basson/qym-solder/README.md

# qym-solder
QymSolder - Soldering station  three in one - hakko t12, hot air gun, d909/898D or analog.
