basson/qym-solder/docs/MenuStructure.md

Настройки

- Назад
- Основные
  - Время откл
  - Время выкл
  - Звук вкл/выкл
  - Охлаждение По теримстору/постоянно
  - NTC терм Нет/10k/100k
  - Сбросить настройки
- Hakko T12
  - Калибровка темп
  - Мин темп
  - Макс темп
  - Сенсор Есть/Нет
  - Время перехода в сон
  - Темп во время сна
  - PID калибровка
  - NTC терм Нет/10k/100k
- Solder Iron
  - Калибровка темп
  - Мин темп
  - Макс темп
  - Сенсор Есть/Нет
  - Время перехода в сон
  - Темп во время сна
  - PID калибровка
  - NTC терм Нет/10k/100k
- Hot Air Gun
  - Калибровка темп
  - Мин темп
  - Макс темп
  - Мин поток
  - Макс поток
  - Сенсор Есть/Нет
  - PID калибровка
  - NTC терм Нет/10k/100k
