basson/qym-solder/pcb/pcb.kicad_pcb

## KiCad design pcb/pcb.kicad_pcb (2024-02-05)

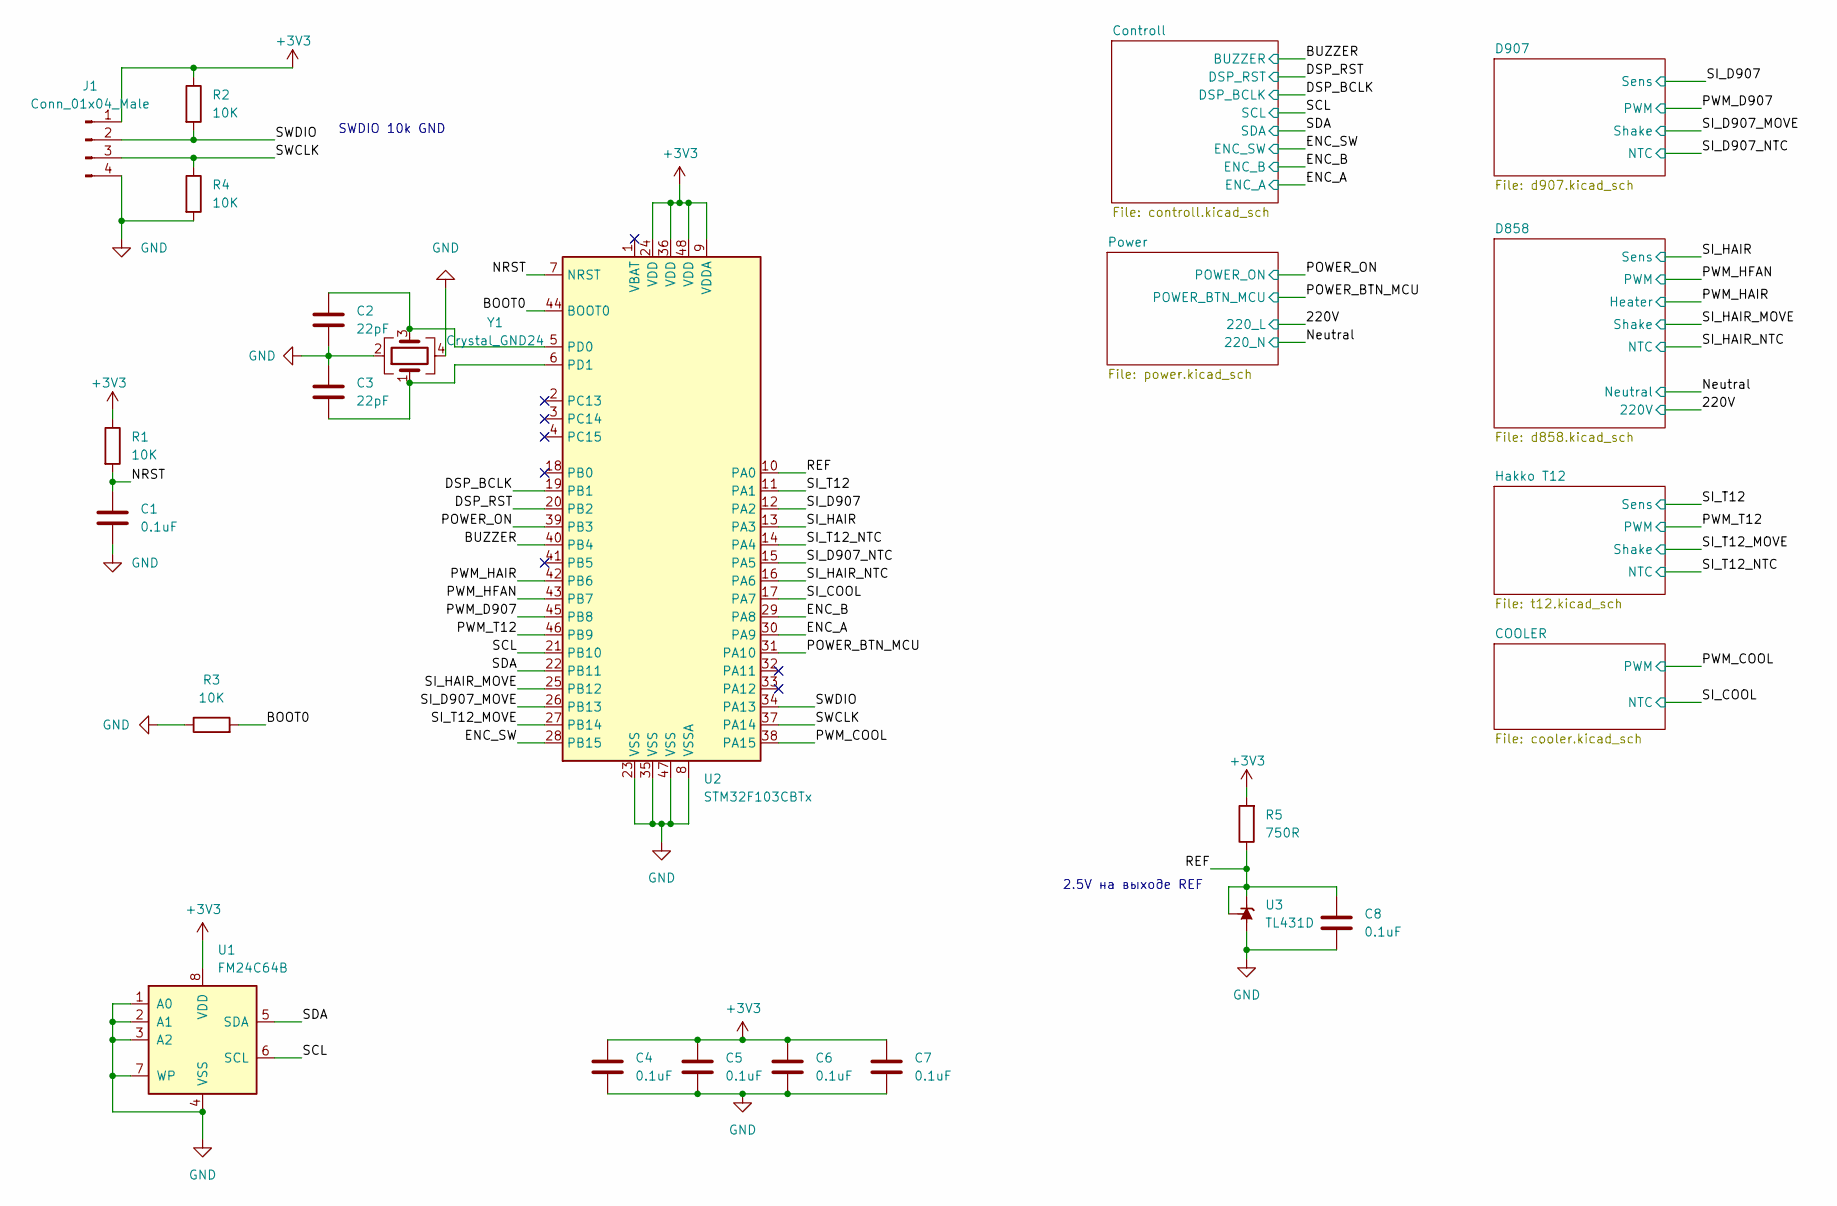
[picture p1: schematic pcb.kicad_sch]

Parts:
C1, C4, C5, C6, C7, C8: 0.1uF; C_1206_3216Metric_Pad1.33x1.80mm_HandSolder
C2, C3: 22pF; C_1206_3216Metric_Pad1.33x1.80mm_HandSolder
J1: Conn_01x04_Male; PinSocket_1x04_P2.54mm_Vertical
R1, R2, R3, R4: 10K; R_1206_3216Metric_Pad1.30x1.75mm_HandSolder
R5: 750R; R_1206_3216Metric_Pad1.30x1.75mm_HandSolder
U1: FM24C64B; SOIC-8_3.9x4.9mm_P1.27mm
U2: STM32F103CBTx; LQFP-48_7x7mm_P0.5mm
U3: TL431D; SOIC-8_3.9x4.9mm_P1.27mm
Y1: Crystal_GND24; Crystal_SMD_5032-4Pin_5.0x3.2mm

Connections:
+3V3: C4.1, C5.1, C6.1, C7.1, J1.1, R1.1, R2.1, R5.2, U1.8 (VDD), U2.9 (VDDA), U2.24 (VDD), U2.36 (VDD), U2.48 (VDD); also elsewhere on the board
/BOOT0: R3.2, U2.44 (BOOT0)
/BUZZER: U2.40 (PB4); also elsewhere on the board
/DSP_BCLK: U2.19 (PB1); also elsewhere on the board
/DSP_RST: U2.20 (PB2); also elsewhere on the board
/ENC_A: U2.30 (PA9); also elsewhere on the board
/ENC_B: U2.29 (PA8); also elsewhere on the board
/ENC_SW: U2.28 (PB15); also elsewhere on the board
/NRST: C1.2, R1.2, U2.7 (NRST)
/POWER_BTN_MCU: U2.31 (PA10); also elsewhere on the board
/POWER_ON: U2.39 (PB3); also elsewhere on the board
/PWM_COOL: U2.38 (PA15); also elsewhere on the board
/PWM_D907: U2.45 (PB8); also elsewhere on the board
/PWM_HAIR: U2.42 (PB6); also elsewhere on the board
/PWM_HFAN: U2.43 (PB7); also elsewhere on the board
/PWM_T12: U2.46 (PB9); also elsewhere on the board
/REF: C8.1, R5.1, U2.10 (PA0), U3.1 (K), U3.8 (REF)
/SCL: U1.6 (SCL), U2.21 (PB10); also elsewhere on the board
/SDA: U1.5 (SDA), U2.22 (PB11); also elsewhere on the board
/SI_COOL: U2.17 (PA7); also elsewhere on the board
/SI_D907: U2.12 (PA2); also elsewhere on the board
/SI_D907_MOVE: U2.26 (PB13); also elsewhere on the board
/SI_D907_NTC: U2.15 (PA5); also elsewhere on the board
/SI_HAIR: U2.13 (PA3); also elsewhere on the board
/SI_HAIR_MOVE: U2.25 (PB12); also elsewhere on the board
/SI_HAIR_NTC: U2.16 (PA6); also elsewhere on the board
/SI_T12: U2.11 (PA1); also elsewhere on the board
/SI_T12_MOVE: U2.27 (PB14); also elsewhere on the board
/SI_T12_NTC: U2.14 (PA4); also elsewhere on the board
/SWCLK: J1.3, R4.1, U2.37 (PA14)
/SWDIO: J1.2, R2.2, U2.34 (PA13)
GND: C1.1, C2.1, C3.2, C4.2, C5.2, C6.2, C7.2, C8.2, J1.4, R3.1, R4.2, U1.1 (A0), U1.2 (A1), U1.3 (A2), U1.4 (VSS), U1.7 (WP), U2.8 (VSSA), U2.23 (VSS), U2.35 (VSS), U2.47 (VSS), U3.2 (A), U3.3 (A), U3.6 (A), U3.7 (A), Y1.2, Y1.4; also elsewhere on the board
unnamed: C2.2, U2.5 (PD0), Y1.3
unnamed: C3.1, U2.6 (PD1), Y1.1

Notes on the sheet:
2.5V на выходе REF
SWDIO 10k GND

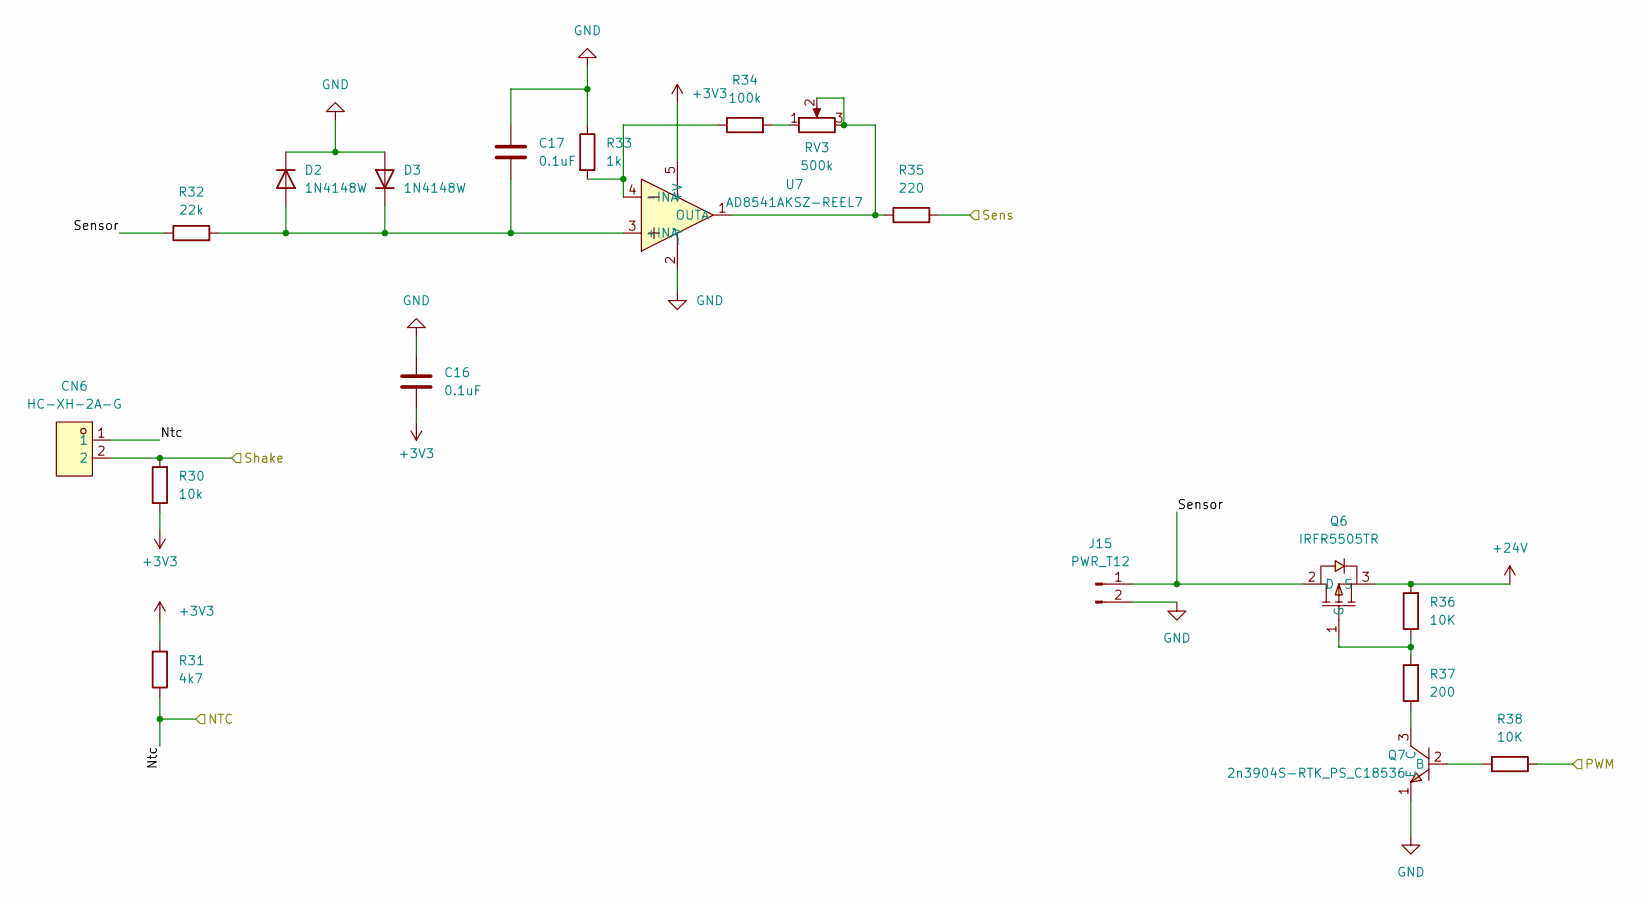
[picture p2: schematic t12.kicad_sch]

Parts:
C16, C17: 0.1uF; C_1206_3216Metric_Pad1.33x1.80mm_HandSolder
CN6: HC-XH-2A-G; CONN-TH_2P-P2.50_HC-XH-2A-G; LCSC Part C5341201
D2, D3: 1N4148W; D_SOD-123
J15: PWR_T12; TerminalBlock_Phoenix_MKDS-1,5-2_1x02_P5.00mm_Horizontal
Q6: IRFR5505TR; TO-252-3_L6.5-W5.8-P4.58-BR; LCSC Part C725084
Q7: 2n3904S-RTK_PS_C18536; SOT-23-3_L2.9-W1.3-P1.90-LS2.4-TR; LCSC Part C18536
R30: 10k; R_1206_3216Metric_Pad1.30x1.75mm_HandSolder
R31: 4k7; R_1206_3216Metric_Pad1.30x1.75mm_HandSolder
R32: 22k; R_1206_3216Metric_Pad1.30x1.75mm_HandSolder
R33: 1k; R_1206_3216Metric_Pad1.30x1.75mm_HandSolder
R34: 100k; R_1206_3216Metric_Pad1.30x1.75mm_HandSolder
R35: 220; R_1206_3216Metric_Pad1.30x1.75mm_HandSolder
R36, R38: 10K; R_1206_3216Metric_Pad1.30x1.75mm_HandSolder
R37: 200; R_1206_3216Metric_Pad1.30x1.75mm_HandSolder
RV3: 500k; Potentiometer_Bourns_3296W_Vertical
U7: AD8541AKSZ-REEL7; SOT-23-5; LCSC Part C143907

Connections:
+3V3: C16.2, R30.1, R31.2, U7.5 (+V); also elsewhere on the board
+24V: Q6.3 (S), R36.2; also elsewhere on the board
/Hakko T12/Sensor: J15.1, Q6.2 (D), R32.1
/PWM_T12: R38.1; also elsewhere on the board
/SI_T12: R35.2; also elsewhere on the board
/SI_T12_MOVE: CN6.2, R30.2; also elsewhere on the board
/SI_T12_NTC: CN6.1, R31.1; also elsewhere on the board
GND: C16.1, C17.1, D2.1 (K), D3.2 (A), J15.2, Q7.1 (E), R33.1, U7.2 (-V); also elsewhere on the board
unnamed: C17.2, D2.2 (A), D3.1 (K), R32.2, U7.3 (+INA)
unnamed: Q6.1 (G), R36.1, R37.2
unnamed: Q7.2 (B), R38.2
unnamed: Q7.3 (C), R37.1
unnamed: R34.2, RV3.1
unnamed: R33.2, R34.1, U7.4 (-INA)
unnamed: R35.1, RV3.2, RV3.3, U7.1 (OUTA)

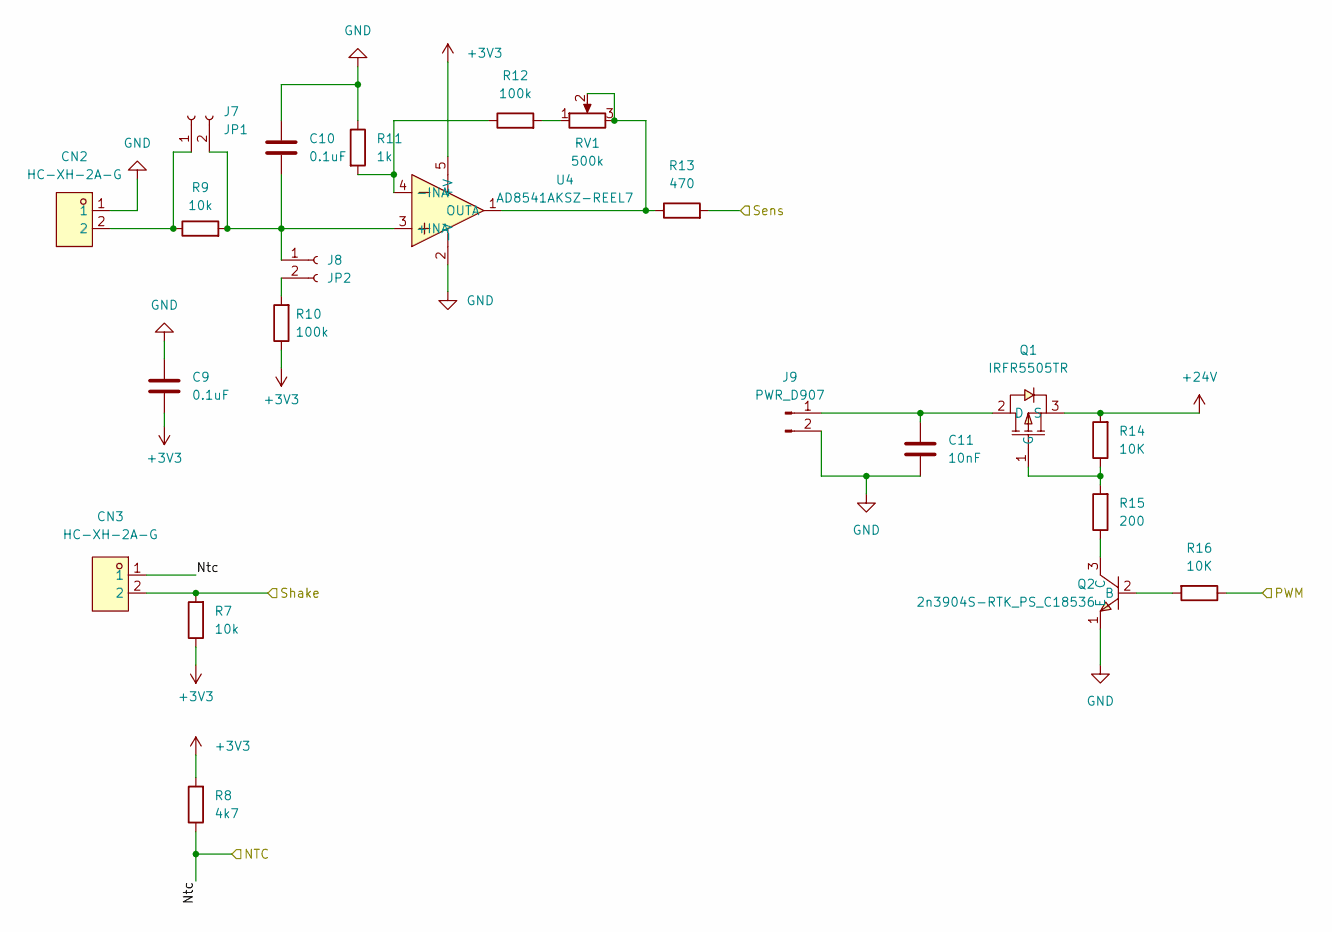
[picture p3: schematic d907.kicad_sch]

Parts:
C9, C10: 0.1uF; C_1206_3216Metric_Pad1.33x1.80mm_HandSolder
C11: 10nF; C_1206_3216Metric_Pad1.33x1.80mm_HandSolder
CN2, CN3: HC-XH-2A-G; CONN-TH_2P-P2.50_HC-XH-2A-G; LCSC Part C5341201
J7: JP1; PinSocket_1x02_P2.54mm_Vertical
J8: JP2; PinSocket_1x02_P2.54mm_Vertical
J9: PWR_D907; TerminalBlock_Phoenix_MKDS-1,5-2_1x02_P5.00mm_Horizontal
Q1: IRFR5505TR; TO-252-3_L6.5-W5.8-P4.58-BR; LCSC Part C725084
Q2: 2n3904S-RTK_PS_C18536; SOT-23-3_L2.9-W1.3-P1.90-LS2.4-TR; LCSC Part C18536
R7, R9: 10k; R_1206_3216Metric_Pad1.30x1.75mm_HandSolder
R8: 4k7; R_1206_3216Metric_Pad1.30x1.75mm_HandSolder
R10, R12: 100k; R_1206_3216Metric_Pad1.30x1.75mm_HandSolder
R11: 1k; R_1206_3216Metric_Pad1.30x1.75mm_HandSolder
R13: 470; R_1206_3216Metric_Pad1.30x1.75mm_HandSolder
R14, R16: 10K; R_1206_3216Metric_Pad1.30x1.75mm_HandSolder
R15: 200; R_1206_3216Metric_Pad1.30x1.75mm_HandSolder
RV1: 500k; Potentiometer_Bourns_3296W_Vertical
U4: AD8541AKSZ-REEL7; SOT-23-5; LCSC Part C143907

Connections:
+3V3: C9.2, R7.1, R8.2, R10.1, U4.5 (+V); also elsewhere on the board
+24V: Q1.3 (S), R14.2; also elsewhere on the board
/PWM_D907: R16.1; also elsewhere on the board
/SI_D907: R13.2; also elsewhere on the board
/SI_D907_MOVE: CN3.2, R7.2; also elsewhere on the board
/SI_D907_NTC: CN3.1, R8.1; also elsewhere on the board
GND: C9.1, C10.1, C11.1, CN2.1, J9.2, Q2.1 (E), R11.1, U4.2 (-V); also elsewhere on the board
unnamed: CN2.2, J7.1, R9.1
unnamed: C10.2, J7.2, J8.1, R9.2, U4.3 (+INA)
unnamed: J8.2, R10.2
unnamed: C11.2, J9.1, Q1.2 (D)
unnamed: Q1.1 (G), R14.1, R15.2
unnamed: Q2.2 (B), R16.2
unnamed: Q2.3 (C), R15.1
unnamed: R12.2, RV1.1
unnamed: R11.2, R12.1, U4.4 (-INA)
unnamed: R13.1, RV1.2, RV1.3, U4.1 (OUTA)

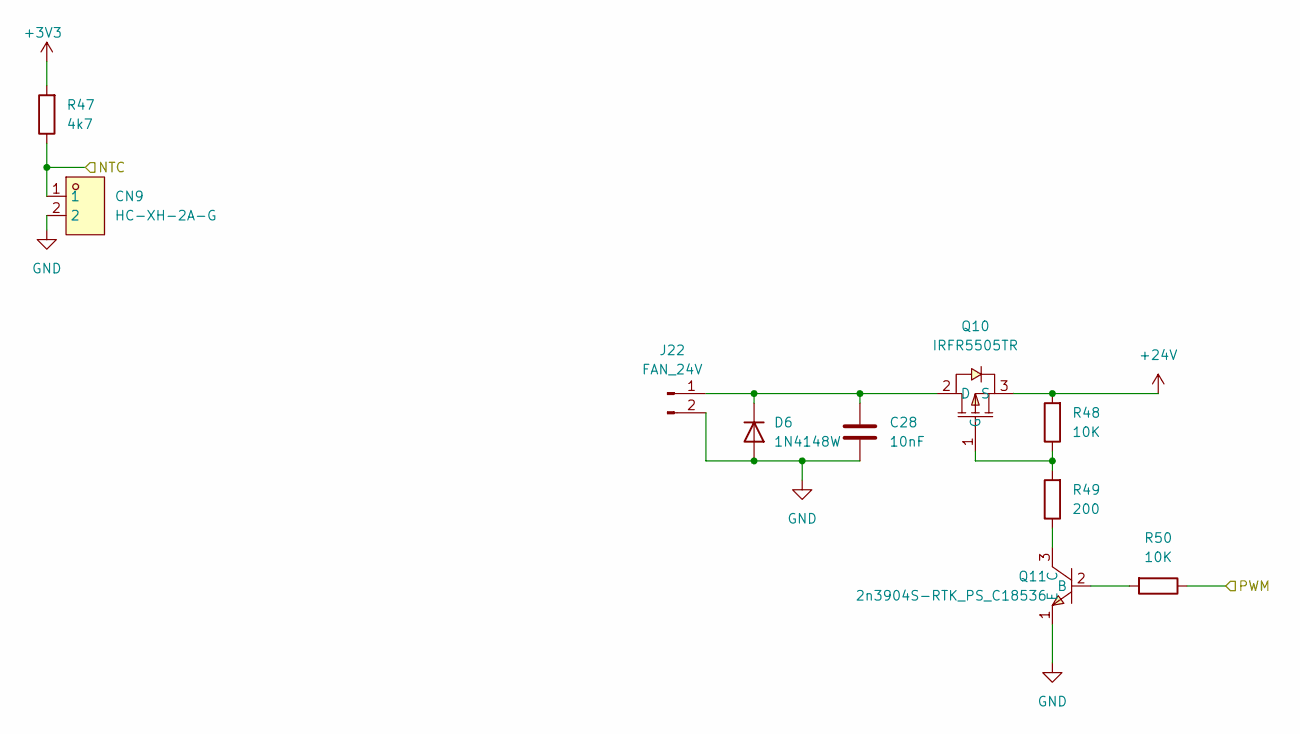
[picture p4: schematic cooler.kicad_sch]

Parts:
C28: 10nF; C_1206_3216Metric_Pad1.33x1.80mm_HandSolder
CN9: HC-XH-2A-G; CONN-TH_2P-P2.50_HC-XH-2A-G; LCSC Part C5341201
D6: 1N4148W; D_SOD-123
J22: FAN_24V; TerminalBlock_Phoenix_MKDS-1,5-2_1x02_P5.00mm_Horizontal
Q10: IRFR5505TR; TO-252-3_L6.5-W5.8-P4.58-BR; LCSC Part C725084
Q11: 2n3904S-RTK_PS_C18536; SOT-23-3_L2.9-W1.3-P1.90-LS2.4-TR; LCSC Part C18536
R47: 4k7; R_1206_3216Metric_Pad1.30x1.75mm_HandSolder
R48, R50: 10K; R_1206_3216Metric_Pad1.30x1.75mm_HandSolder
R49: 200; R_1206_3216Metric_Pad1.30x1.75mm_HandSolder

Connections:
+3V3: R47.2; also elsewhere on the board
+24V: Q10.3 (S), R48.2; also elsewhere on the board
/PWM_COOL: R50.1; also elsewhere on the board
/SI_COOL: CN9.1, R47.1; also elsewhere on the board
GND: C28.1, CN9.2, D6.2 (A), J22.2, Q11.1 (E); also elsewhere on the board
unnamed: C28.2, D6.1 (K), J22.1, Q10.2 (D)
unnamed: Q10.1 (G), R48.1, R49.2
unnamed: Q11.2 (B), R50.2
unnamed: Q11.3 (C), R49.1

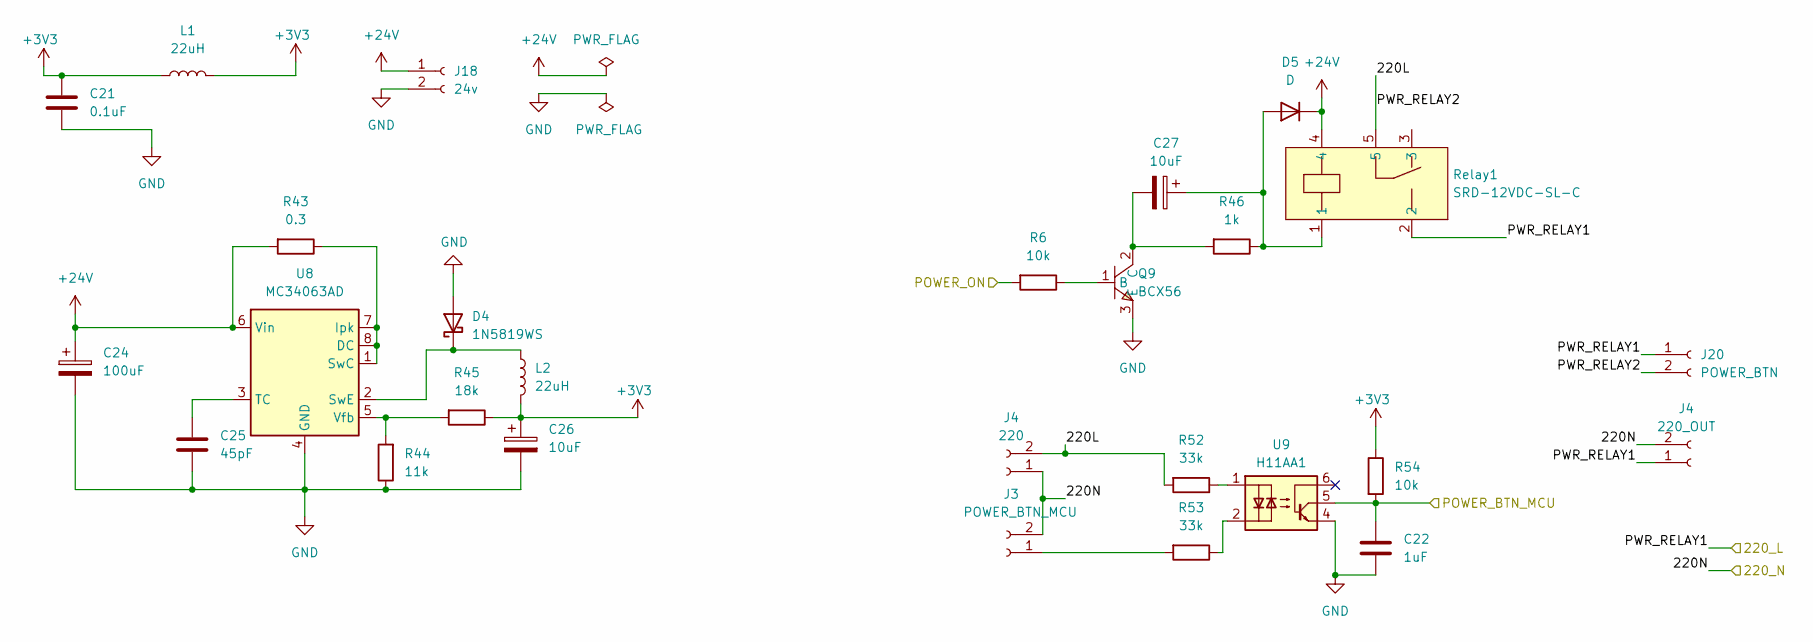
[picture p5: schematic power.kicad_sch]

Parts:
C21: 0.1uF; C_1206_3216Metric_Pad1.33x1.80mm_HandSolder
C22: 1uF; C_1206_3216Metric_Pad1.33x1.80mm_HandSolder
C24: 100uF; CP_Radial_D8.0mm_P3.80mm
C25: 45pF; C_1206_3216Metric_Pad1.33x1.80mm_HandSolder
C26, C27: 10uF; CP_Radial_D5.0mm_P2.50mm
D4: 1N5819WS; D_2114_3652Metric_Pad1.85x3.75mm_HandSolder
D5: D; D_SMA_Handsoldering
J3: POWER_BTN_MCU; TerminalBlock_Phoenix_MKDS-1,5-2_1x02_P5.00mm_Horizontal
J4: 220; TerminalBlock_Phoenix_MKDS-1,5-2_1x02_P5.00mm_Horizontal
J18: 24v; TerminalBlock_Phoenix_MKDS-1,5-2_1x02_P5.00mm_Horizontal
J20: POWER_BTN; TerminalBlock_Phoenix_MKDS-1,5-2_1x02_P5.00mm_Horizontal
L1: 22uH; L_1206_3216Metric_Pad1.22x1.90mm_HandSolder
L2: 22uH; L_6.3x6.3_H3
Q9: BCX56; SOT-89-3_L4.5-W2.5-P1.50-LS4.2-BR; LCSC Part C24280
R6, R54: 10k; R_1206_3216Metric_Pad1.30x1.75mm_HandSolder
R43: 0.3; R_1206_3216Metric_Pad1.30x1.75mm_HandSolder
R44: 11k; R_1206_3216Metric_Pad1.30x1.75mm_HandSolder
R45: 18k; R_1206_3216Metric_Pad1.30x1.75mm_HandSolder
R46: 1k; R_1206_3216Metric_Pad1.30x1.75mm_HandSolder
R52, R53: 33k; R_2512_6332Metric_Pad1.40x3.35mm_HandSolder
Relay1: SRD-12VDC-SL-C; RELAY-TH_SRD-XXVDC-XL-C; LCSC Part C30431
U8: MC34063AD; SOIC-8_3.9x4.9mm_P1.27mm
U9: H11AA1; DIP-6_W7.62mm_SMDSocket_SmallPads

Connections:
+3V3: C21.1, C26.1, L1.1, L1.2, L2.2, R45.1, R54.1; also elsewhere on the board
+24V: C24.1, D5.1 (K), J18.1, R43.2, Relay1.4, U8.6 (Vin); also elsewhere on the board
/POWER_BTN_MCU: C22.1, R54.2, U9.5; also elsewhere on the board
/POWER_ON: R6.2; also elsewhere on the board
GND: C21.2, C22.2, C24.2, C25.2, C26.2, D4.2 (A), J18.2, Q9.3 (E), R44.1, U8.4 (GND), U9.4; also elsewhere on the board
unnamed: D4.1 (K), L2.1, U8.2 (SwE)
unnamed: C27.1, D5.2 (A), R46.1, Relay1.1
unnamed: J3.1, R53.2
unnamed: Q9.1 (B), R6.1
unnamed: C27.2, Q9.2 (C), R46.2
unnamed: R52.1, U9.1
unnamed: R53.1, U9.2
unnamed: R43.1, U8.1 (SwC), U8.7 (Ipk), U8.8 (DC)
unnamed: C25.1, U8.3 (TC)
unnamed: R44.2, R45.2, U8.5 (Vfb)

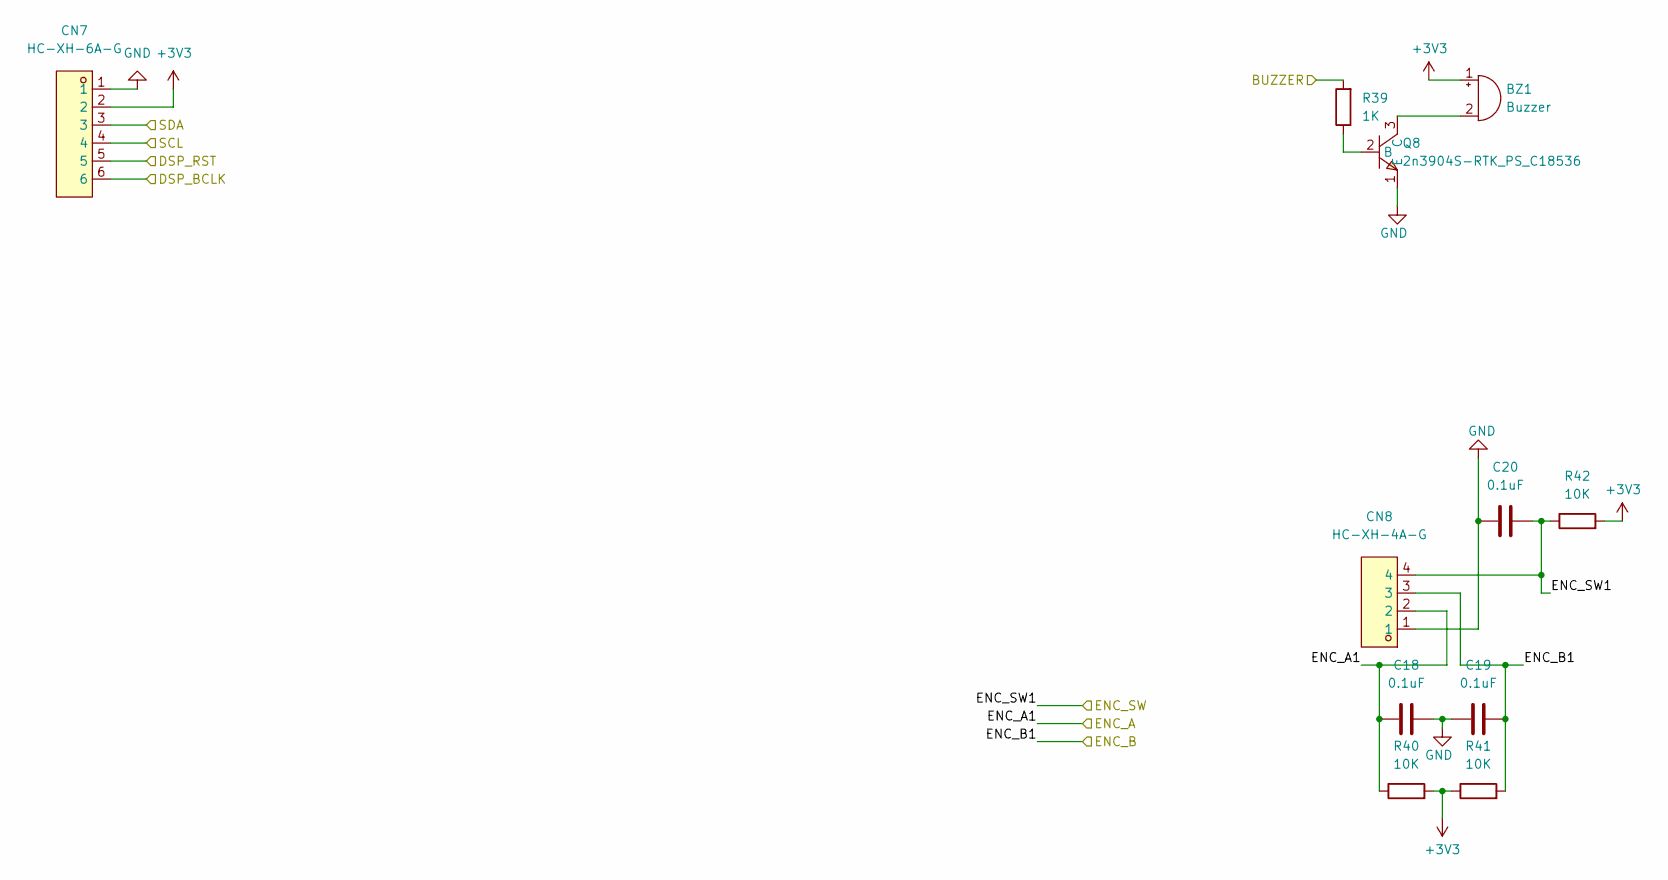
[picture p6: schematic controll.kicad_sch]

Parts:
BZ1: Buzzer; Buzzer_12x9.5RM7.6
C18, C19, C20: 0.1uF; C_1206_3216Metric_Pad1.33x1.80mm_HandSolder
CN7: HC-XH-6A-G; CONN-TH_6P-P2.50_HC-XH-6A-G; LCSC Part C5341205
CN8: HC-XH-4A-G; CONN-TH_4P-P2.50_HC-XH-4A-G; LCSC Part C5341203
Q8: 2n3904S-RTK_PS_C18536; SOT-23-3_L2.9-W1.3-P1.90-LS2.4-TR; LCSC Part C18536
R39: 1K; R_1206_3216Metric_Pad1.30x1.75mm_HandSolder
R40, R41, R42: 10K; R_1206_3216Metric_Pad1.30x1.75mm_HandSolder

Connections:
+3V3: BZ1.1 (-), CN7.2, R40.2, R41.1, R42.2; also elsewhere on the board
/BUZZER: R39.2; also elsewhere on the board
/DSP_BCLK: CN7.6; also elsewhere on the board
/DSP_RST: CN7.5; also elsewhere on the board
/ENC_A: C18.1, CN8.2, R40.1; also elsewhere on the board
/ENC_B: C19.2, CN8.3, R41.2; also elsewhere on the board
/ENC_SW: C20.1, CN8.4, R42.1; also elsewhere on the board
/SCL: CN7.4; also elsewhere on the board
/SDA: CN7.3; also elsewhere on the board
GND: C18.2, C19.1, C20.2, CN7.1, CN8.1, Q8.1 (E); also elsewhere on the board
unnamed: BZ1.2 (+), Q8.3 (C)
unnamed: Q8.2 (B), R39.1

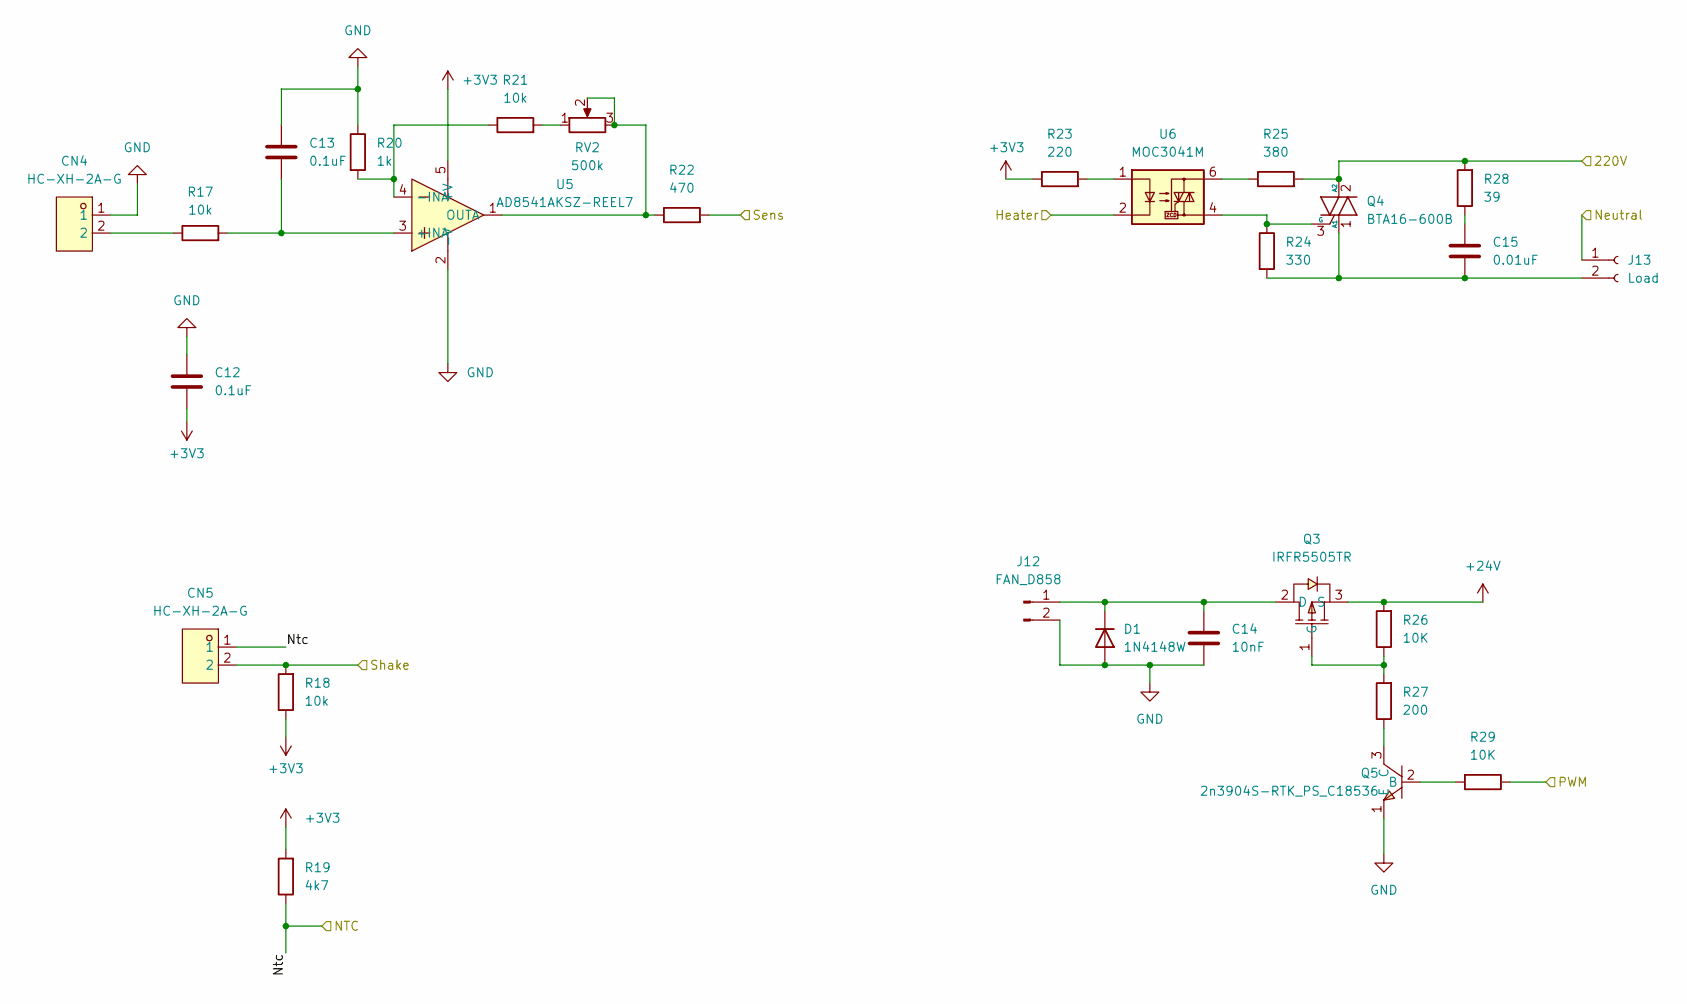
[picture p7: schematic d858.kicad_sch]

Parts:
C12, C13: 0.1uF; C_1206_3216Metric_Pad1.33x1.80mm_HandSolder
C14: 10nF; C_1206_3216Metric_Pad1.33x1.80mm_HandSolder
C15: 0.01uF; C_Disc_D11.0mm_W5.0mm_P5.00mm
CN4, CN5: HC-XH-2A-G; CONN-TH_2P-P2.50_HC-XH-2A-G; LCSC Part C5341201
D1: 1N4148W; D_SOD-123
J12: FAN_D858; TerminalBlock_Phoenix_MKDS-1,5-2_1x02_P5.00mm_Horizontal
J13: Load; TerminalBlock_Phoenix_MKDS-1,5-2_1x02_P5.00mm_Horizontal
Q3: IRFR5505TR; TO-252-3_L6.5-W5.8-P4.58-BR; LCSC Part C725084
Q4: BTA16-600B; TO-220-3_Vertical
Q5: 2n3904S-RTK_PS_C18536; SOT-23-3_L2.9-W1.3-P1.90-LS2.4-TR; LCSC Part C18536
R17, R18, R21: 10k; R_1206_3216Metric_Pad1.30x1.75mm_HandSolder
R19: 4k7; R_1206_3216Metric_Pad1.30x1.75mm_HandSolder
R20: 1k; R_1206_3216Metric_Pad1.30x1.75mm_HandSolder
R22: 470; R_1206_3216Metric_Pad1.30x1.75mm_HandSolder
R23: 220; R_1206_3216Metric_Pad1.30x1.75mm_HandSolder
R24: 330; R_2512_6332Metric_Pad1.40x3.35mm_HandSolder
R25: 380; R_2512_6332Metric_Pad1.40x3.35mm_HandSolder
R26, R29: 10K; R_1206_3216Metric_Pad1.30x1.75mm_HandSolder
R27: 200; R_1206_3216Metric_Pad1.30x1.75mm_HandSolder
R28: 39; R_2512_6332Metric_Pad1.40x3.35mm_HandSolder
RV2: 500k; Potentiometer_Bourns_3296W_Vertical
U5: AD8541AKSZ-REEL7; SOT-23-5; LCSC Part C143907
U6: MOC3041M; DIP-6_W7.62mm_LongPads

Connections:
+3V3: C12.2, R18.1, R19.2, R23.1, U5.5 (+V); also elsewhere on the board
+24V: Q3.3 (S), R26.2; also elsewhere on the board
/PWM_HAIR: U6.2; also elsewhere on the board
/PWM_HFAN: R29.1; also elsewhere on the board
/SI_HAIR: R22.2; also elsewhere on the board
/SI_HAIR_MOVE: CN5.2, R18.2; also elsewhere on the board
/SI_HAIR_NTC: CN5.1, R19.1; also elsewhere on the board
GND: C12.1, C13.1, C14.1, CN4.1, D1.2 (A), J12.2, Q5.1 (E), R20.1, U5.2 (-V); also elsewhere on the board
unnamed: C15.1, R28.1
unnamed: CN4.2, R17.1
unnamed: C14.2, D1.1 (K), J12.1, Q3.2 (D)
unnamed: C15.2, J13.2, Q4.1 (A1), R24.2
unnamed: Q3.1 (G), R26.1, R27.2
unnamed: Q4.3 (G), R24.1, U6.4
unnamed: Q5.2 (B), R29.2
unnamed: Q5.3 (C), R27.1
unnamed: R21.2, RV2.1
unnamed: R23.2, U6.1
unnamed: R25.1, U6.6
unnamed: C13.2, R17.2, U5.3 (+INA)
unnamed: R20.2, R21.1, U5.4 (-INA)
unnamed: R22.1, RV2.2, RV2.3, U5.1 (OUTA)

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
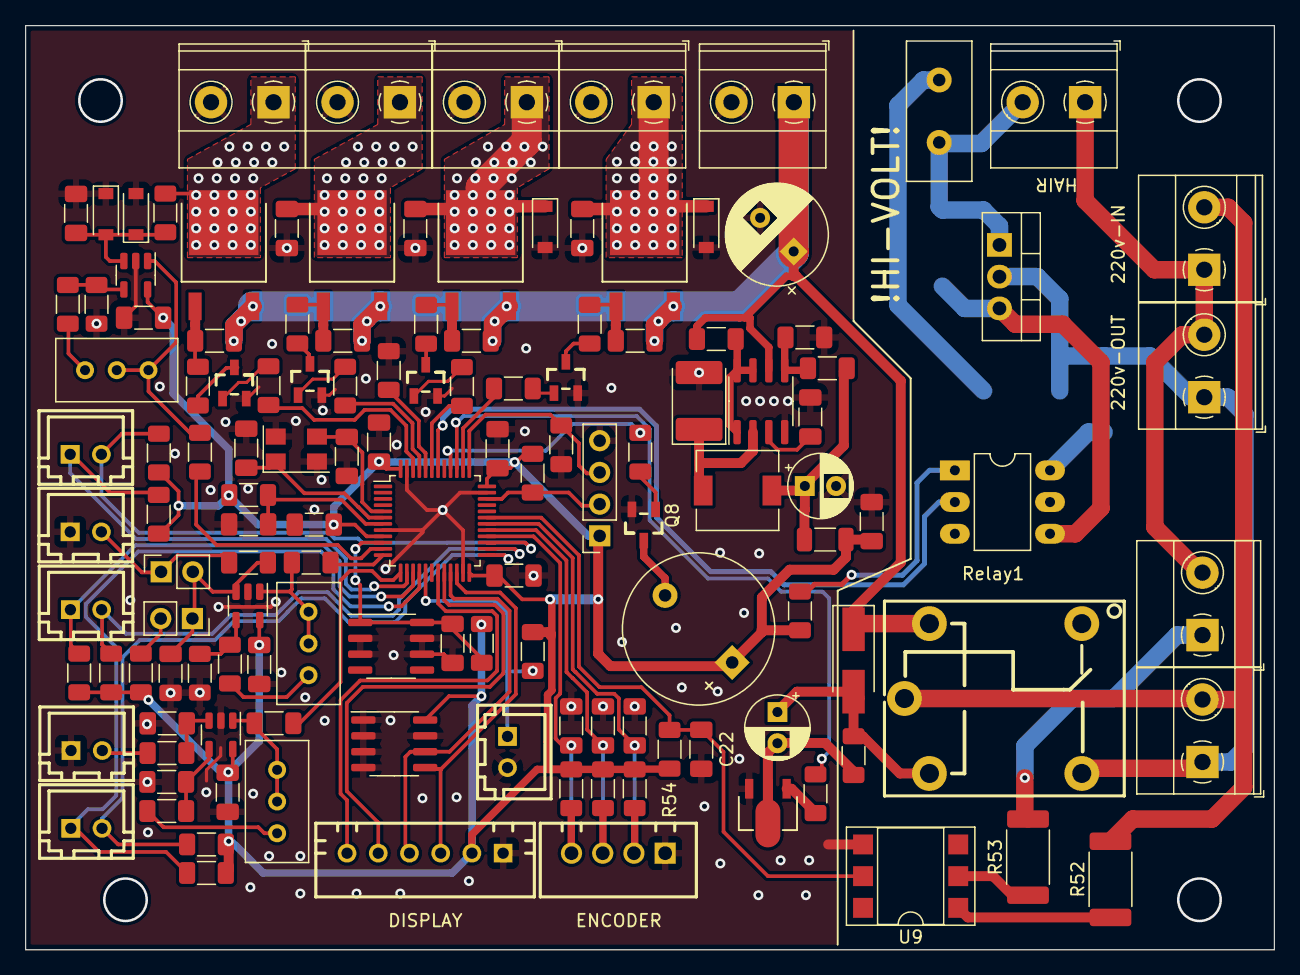
[picture p8: board pcb.kicad_pcb from above]

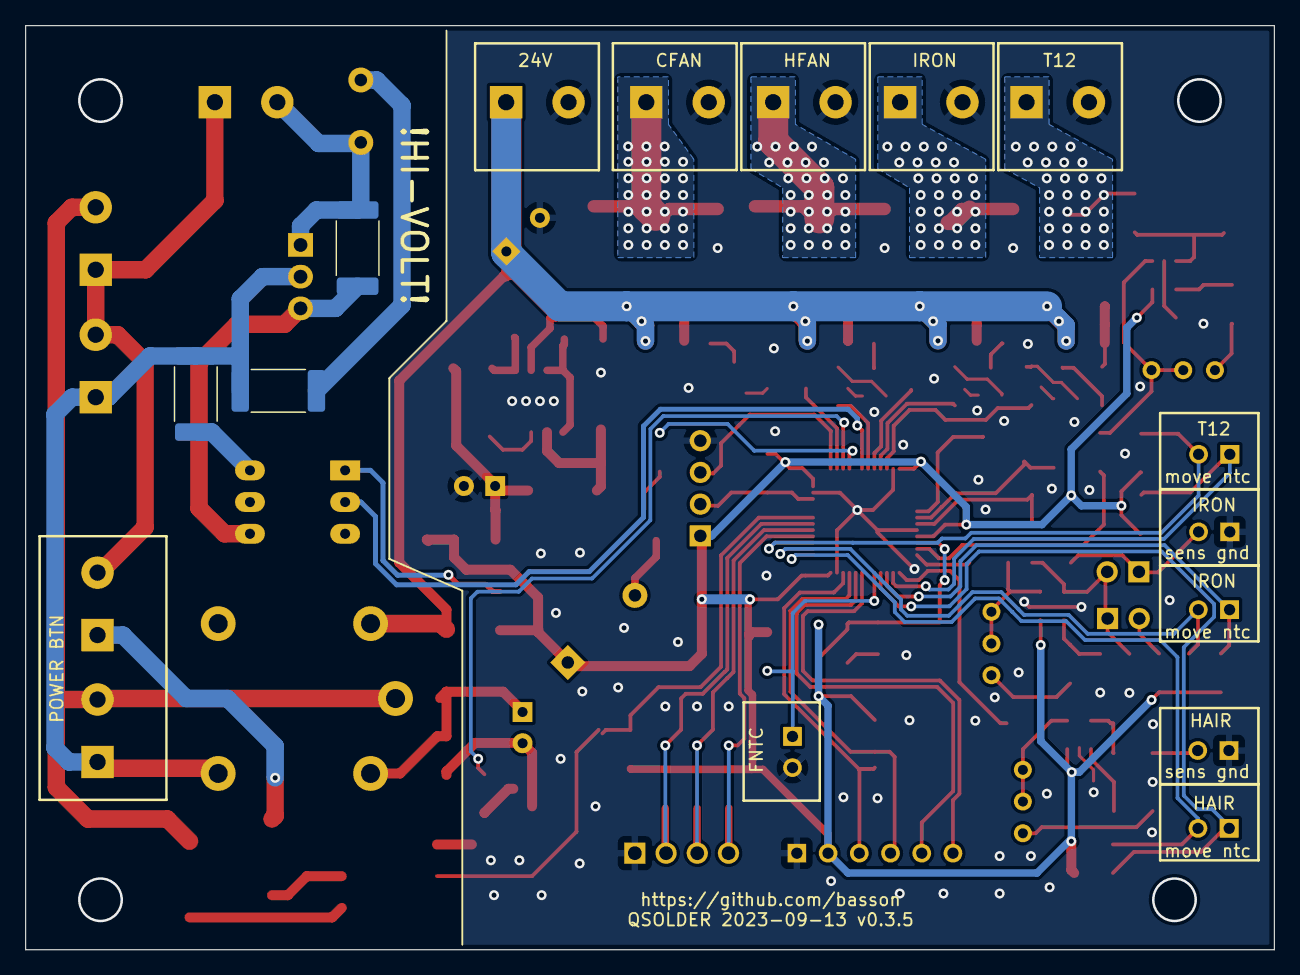
[picture p9: board pcb.kicad_pcb from below]

Board: 2 copper layers, 100.0 x 74.0 mm, 135 parts (3 on the bottom side), 86 nets.

Other parts of the board:
J2: 220; TerminalBlock_Phoenix_MKDS-1,5-2_1x02_P5.00mm_Horizontal
