basson/qym-solder/code/Src/main.cpp

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
/* Includes ------------------------------------------------------------------*/
#include "main.h"
#include "adc.h"
#include "dma.h"
#include "i2c.h"
#include "tim.h"
#include "gpio.h"

/* USER CODE BEGIN Includes */
#include "app.hpp"
/* USER CODE END Includes */


void SystemClock_Config(void);
/**
  * @brief  The application entry point.
  * @retval int
  */
int main(void)
{

  /* MCU Configuration--------------------------------------------------------*/

  /* Reset of all peripherals, Initializes the Flash interface and the Systick. */
  HAL_Init();

  /* Configure the system clock */
  SystemClock_Config();

  /* Initialize all configured peripherals */
  MX_GPIO_Init();
  MX_DMA_Init();
  MX_ADC1_Init();
  MX_I2C2_Init();
  MX_TIM1_Init();
  MX_TIM4_Init();
  MX_TIM2_Init();
  MX_ADC2_Init();
  /* USER CODE BEGIN 2 */
  HAL_TIM_Encoder_Start(&htim1, TIM_CHANNEL_1);
  HAL_TIM_PWM_Start(&htim4, TIM_CHANNEL_1);
  
  Initialize();
  /* USER CODE END 2 */

  /* Infinite loop */
  /* USER CODE BEGIN WHILE */
  while (1)
  {
    /* USER CODE END WHILE */

    /* USER CODE BEGIN 3 */
    Main();
  }
  /* USER CODE END 3 */
}

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
/* USER CODE BEGIN 4 */
void SysTick_interrupt()
{
  SysTickInterrupt();
}
void HAL_GPIO_EXTI_Callback(uint16_t GPIO_Pin)
{
  PinCallback(GPIO_Pin);
}
void HAL_ADC_ConvCpltCallback(ADC_HandleTypeDef *hadc)
{
  AdcCallback(hadc);
}

/* USER CODE END 4 */
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
