basson/qym-solder/code/Src/control.cpp

#include "control.hpp"

uint16_t Control::_adcCoupleHacckoT12 = 0;
uint16_t Control::_adcNtcHacckoT12 = 0;

uint16_t Control::_adcCoupleSolderHand = 0;
uint16_t Control::_adcNtcSolderHand = 0;

uint16_t Control::_adcCoupleHairGun = 0;
uint16_t Control::_adcNtcHairGun = 0;

uint16_t Control::_currentTempHakkoT12 = 0;
uint16_t Control::_currentTempSolderHand = 0;
uint16_t Control::_currentTempHairGun = 0;

Control::State Control::_stateHakkoT12 = CONTROL_STATE_OFF;
Control::State Control::_stateSolderHand = CONTROL_STATE_OFF;
Control::State Control::_stateHairGun = CONTROL_STATE_OFF;

Control::Trigger Control::_trigger = {false, false, false};

Control::Control()
{
}

void Control::Initialize()
{
    _emem = Emem::GetInstance();

    _emaHakkoT12.SetK(0.06);
    _emaSolderHand.SetK(0.06);
    _emaHairGun.SetK(0.06);

    _timerHakkoT12.SetRepeat(false);
    _timerSolderHand.SetRepeat(false);

    _pidDataHakkoT12.OutputMin = 0;
    _pidDataHakkoT12.OutputMax = 3999;
    _pidDataHakkoT12.SampleTimeMs = 4;

    _pidDataSolderHand.OutputMin = 0;
    _pidDataSolderHand.OutputMax = 3999;
    _pidDataSolderHand.SampleTimeMs = 4;

    _pidDataHairGun.OutputMin = 0;
    _pidDataHairGun.OutputMax = 3999;
    _pidDataHairGun.SampleTimeMs = 4;

    TIM4->CCR4 = 0;
    TIM4->CCR3 = 0;
    TIM4->CCR1 = 3999;
}

void Control::Process()
{
    ProcessHakktoT12();
    ProcessSolderHand();
    ProcessHairGun();
}

void Control::CallbackHakkoT12Move()
{
    _timerHakkoT12.SetInterval((_emem->Param().t12TimeSleep[0] * 60 * 60 + _emem->Param().t12TimeSleep[1] * 60 + _emem->Param().t12TimeSleep[0]) * 1000);
    _timerHakkoT12.On();
    if (_stateHakkoT12 == CONTROL_STATE_SLEEP)
        _stateHakkoT12 = CONTROL_STATE_ON;
}
void Control::CallbackSolderHandMove()
{
    _timerSolderHand.SetInterval((_emem->Param().ironTimeSleep[0] * 60 * 60 + _emem->Param().ironTimeSleep[1] * 60 + _emem->Param().ironTimeSleep[0]) * 1000);
    _timerSolderHand.On();
    if (_stateSolderHand == CONTROL_STATE_SLEEP)
        _stateSolderHand = CONTROL_STATE_ON;
}
void Control::CallbackHairGunStand(bool direction)
{
    // if (direction)
    //     _stateHairGun = CONTROL_STATE_ON;
    // else
    //     _stateHairGun = CONTROL_STATE_OFF;
}

void Control::SetAdcNtcHakkoT12(uint16_t value)
{
    _adcNtcHacckoT12 = value;
}
void Control::SetAdcCoupleSolderHand(uint16_t value)
{
    _adcCoupleSolderHand = value;
}
void Control::SetAdcNtcSolderHand(uint16_t value)
{
    _adcNtcSolderHand = value;
}
void Control::SetAdcCoupleHairGun(uint16_t value)
{
    _adcCoupleHairGun = value;
}
void Control::SetAdcNtcHairGun(uint16_t value)
{
    _adcNtcHairGun = value;
}

uint16_t Control::GetCurrentTempHakkoT12()
{
    return _currentTempHakkoT12;
}
uint16_t Control::GetCurrentTempSolderHand()
{
    return _currentTempSolderHand;
}
uint16_t Control::GetCurrentTempHairGun()
{
    return _currentTempHairGun;
}

Control::State Control::StateHakkoT12(Control::State state)
{
    if (state == CONTROL_STATE_MAX)
        return _stateHakkoT12;
    _stateHakkoT12 = state;
    _trigger.hakkoT12 = true;
    return _stateHakkoT12;
}
Control::State Control::StateSolderHand(Control::State state)
{
    if (state == CONTROL_STATE_MAX)
        return _stateSolderHand;
    _stateSolderHand = state;
    _trigger.solderHand = true;
    return _stateSolderHand;
}
Control::State Control::StateHairGun(Control::State state)
{
    if (state == CONTROL_STATE_MAX)
        return _stateHairGun;
    _stateHairGun = state;
    _trigger.hairGun = true;
    return _stateHairGun;
}

void Control::ProcessHakktoT12()
{
    uint16_t _filterAdc = 0;
    GetAdcCoupleHakkoT12();

    _medianHakkoT12.Set(_adcCoupleHacckoT12);
    _emaHakkoT12.Set(_medianHakkoT12.Get());
    _filterAdc = _emaHakkoT12.Get();
    _currentTempHakkoT12 = 0.1320134f * _filterAdc + 21.43212233f;

    if (_stateHakkoT12 == CONTROL_STATE_OFF && !_trigger.solderHand)
        return;

    _timerHakkoT12.Process();
    if (_timerHakkoT12.Elapsed())
    {
        _stateHakkoT12 = CONTROL_STATE_SLEEP;
    }

    if (_stateHakkoT12 == CONTROL_STATE_SLEEP)
        _pidDataHakkoT12.Point = _emem->Param().t12TempSleep;
    else
        _pidDataHakkoT12.Point = _emem->Param().t12SetTemp;

    _pidDataHakkoT12.Kp = _emem->Param().t12Kp;
    _pidDataHakkoT12.Ki = _emem->Param().t12Ki;
    _pidDataHakkoT12.Kd = _emem->Param().t12Kd;
    _pidDataHakkoT12.Inpit = _currentTempHakkoT12;

    qymos::common::Pid::SetData(&_pidDataHakkoT12);
    qymos::common::Pid::Process();


    TIM4->CCR4 = _pidDataHakkoT12.Output;

    if (_trigger.hakkoT12)
    {
        if (_stateHakkoT12 == CONTROL_STATE_ON)
        {
            HAL_TIM_PWM_Start(&htim4, TIM_CHANNEL_4);
            _timerHakkoT12.SetInterval((_emem->Param().t12TimeSleep[0] * 60 * 60 + _emem->Param().t12TimeSleep[1] * 60 + _emem->Param().t12TimeSleep[0]) * 1000);
            _timerHakkoT12.On();
        }
        else
        {
            _stateHakkoT12 = CONTROL_STATE_OFF;
            HAL_TIM_PWM_Stop(&htim4, TIM_CHANNEL_4);
            _timerHakkoT12.Off();
        }
        _trigger.hakkoT12 = false;
    }
}
void Control::ProcessSolderHand()
{
    uint16_t _filterAdc = 0;

    _medianSolderHand.Set(_adcCoupleSolderHand);
    _emaSolderHand.Set(_medianSolderHand.Get());
    _filterAdc = _emaSolderHand.Get();
    _currentTempSolderHand = 0.1320134f * _filterAdc + 21.43212233f;

    if (_stateSolderHand == CONTROL_STATE_OFF && !_trigger.solderHand)
        return;

    _timerSolderHand.Process();
    if (_timerSolderHand.Elapsed())
    {
        _stateSolderHand = CONTROL_STATE_SLEEP;
    }

    if (_stateSolderHand == CONTROL_STATE_SLEEP)
        _pidDataSolderHand.Point = _emem->Param().ironTempSleep;
    else
        _pidDataSolderHand.Point = _emem->Param().ironSetTemp;

    _pidDataSolderHand.Kp = _emem->Param().ironKp;
    _pidDataSolderHand.Ki = _emem->Param().ironKi;
    _pidDataSolderHand.Kd = _emem->Param().ironKd;
    _pidDataSolderHand.Inpit = _currentTempSolderHand;

    qymos::common::Pid::SetData(&_pidDataSolderHand);
    qymos::common::Pid::Process();

    TIM4->CCR3 = _pidDataSolderHand.Output;

    if (_trigger.solderHand)
    {
        if (_stateSolderHand == CONTROL_STATE_ON)
        {
            HAL_TIM_PWM_Start(&htim4, TIM_CHANNEL_3);
            _timerSolderHand.SetInterval((_emem->Param().ironTimeSleep[0] * 60 * 60 + _emem->Param().ironTimeSleep[1] * 60 + _emem->Param().ironTimeSleep[0]) * 1000);
            _timerSolderHand.On();
        }
        else
        {
            _stateSolderHand = CONTROL_STATE_OFF;
            HAL_TIM_PWM_Stop(&htim4, TIM_CHANNEL_3);
            _timerSolderHand.Off();
        }
        _trigger.solderHand = false;
    }
}

void Control::ProcessHairGun()
{
    uint16_t _filterAdc = 0;
    _medianHairGun.Set(_adcCoupleHairGun);
    _emaHairGun.Set(_medianHairGun.Get());
    _filterAdc = _emaHairGun.Get();
    _currentTempHairGun = 0.10779499 * _filterAdc + 19.11698252;

    if (_stateHairGun != CONTROL_STATE_ON && _currentTempHairGun >= 50)
        _stateHairGun = CONTROL_STATE_COOLING;

    if (_stateHairGun == CONTROL_STATE_COOLING)
    {
        if (_currentTempHairGun >= 50)
        {
            HAL_TIM_PWM_Start(&htim4, TIM_CHANNEL_2);
            TIM4->CCR2 = 3999;
        }
        if (_currentTempHairGun <= 37)
        {
            HAL_TIM_PWM_Stop(&htim4, TIM_CHANNEL_2);
            _stateHairGun = CONTROL_STATE_OFF;
        }
    }

    // if (_stateHairGun == CONTROL_STATE_OFF && !_trigger.hairGun)
    //     return;

    if (_stateHairGun == CONTROL_STATE_ON)
    {

        TIM4->CCR2 = (((float)3999 / 100) * _emem->Param().hairSetFlow);

        _pidDataHairGun.Point = _emem->Param().hairSetTemp;

        _pidDataHairGun.Kp = _emem->Param().hairKp;
        _pidDataHairGun.Ki = _emem->Param().hairKi;
        _pidDataHairGun.Kd = _emem->Param().hairKd;
        _pidDataHairGun.Inpit = _currentTempHairGun;

        qymos::common::Pid::SetData(&_pidDataHairGun);
        qymos::common::Pid::Process();

        TIM4->CCR1 = 3999 - _pidDataHairGun.Output;
    }
    else
    {
        _pidDataHairGun.Integral = 0;
        _pidDataHairGun.Error = 0;
        TIM4->CCR1 = 3999;
    }

    if (_trigger.hairGun)
    {
        if (_stateHairGun == CONTROL_STATE_ON)
            HAL_TIM_PWM_Start(&htim4, TIM_CHANNEL_2);
        else
        {
            _stateHairGun = CONTROL_STATE_COOLING;
            TIM4->CCR1 = 3999;
        }
        _trigger.hairGun = false;
    }
}

void Control::GetAdcCoupleHakkoT12()
{

    if (_stateHakkoT12 == CONTROL_STATE_ON || _stateHakkoT12 == CONTROL_STATE_SLEEP)
        HAL_TIM_PWM_Stop(&htim4, TIM_CHANNEL_4);

    HAL_Delay(15);
    HAL_ADC_Start(&hadc2);
    HAL_ADC_PollForConversion(&hadc2, 100);
    _adcCoupleHacckoT12 = HAL_ADC_GetValue(&hadc2);
    HAL_ADC_Stop(&hadc2);

    if (_stateHakkoT12 == CONTROL_STATE_ON || _stateHakkoT12 == CONTROL_STATE_SLEEP)
        HAL_TIM_PWM_Start(&htim4, TIM_CHANNEL_4);
}
