basson/qym-solder/code/Inc/screens.hpp

#pragma once

enum Screen
{
    SCREEN_SHUTDOWN,
    SCREEN_ERROR,
    
    SCREEN_MAIN,
    
    SCREEN_CONFIG,
    
    SCREEN_CONFIG_DEFAULT,
    
    SCREEN_CONFIG_HAKKO_T12,
    SCREEN_CONFIG_SOLDER_HAND,
    SCREEN_CONFIG_HAIR_GUN,

    SCREEN_CONFIG_PID_AUTOTUNE,

    SCREEN_EXAMPLE,

    SCREEN_MAX
};
