basson/qym-solder/(commit log)

2024-01-06 First commit on all source
    [controll.kicad_sch, cooler.kicad_sch, d858.kicad_sch, d907.kicad_sch, pcb.kicad_pcb, pcb.kicad_sch, power.kicad_sch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]
2024-01-06 Release base screens, and base functionan encoder and buttons.
2024-01-07 Small refract naming. Release screen static makeup on config T12, HAir Gun and Solder Hand. And release navigate for config menu.
2024-01-13 Нарисованы все иконки для меню в 8px Реализованы все всплывающие диалоги в меню настроек паяльных ручек. Сверстан экран для PidAutotune
2024-01-14 Tested app LCD Image Converter and fix IconFlow12px.h
    [app.cpp, hair_gun.cpp, hair_gun.hpp]
2024-01-14 Update qymos-stm32-gui-monochrome
2024-01-24 Добавили функционал включения выключения выбора температуры на табы (Хакко Т12, Простой паяльник). Добавили сон и работу паяльников и фена
2024-01-24 add back qymos-stm32-common library for submodules
2024-02-04 update ssd1306 drivers
2024-02-05 Use new class on library qymos-hui (buttonIrq)
2024-02-05 Change resistense on R46 to 1k (add raleay on more power)
    [controll.kicad_sch, cooler.kicad_sch, d858.kicad_sch, d907.kicad_sch, pcb.kicad_pcb, pcb.kicad_sch, power.kicad_sch, t12.kicad_sch]
2024-04-06 Fix Controll class (work corectly hot air gun and solders. and some fix
    [QSTest.ioc, app.cpp, control.cpp, control.hpp, hair_gun.cpp, main.cpp, solder_hand.cpp]
2024-04-07 Add Logo,Warging, Error icons. Add Startup screen and Shutdown.
    [app.cpp, hair_gun.cpp, screens.hpp, shutdown.cpp, shutdown.hpp]
2024-05-05 Fix string warning (const char array), and some warrnings.
    [pcb.kicad_sch]
